windundsterne/esp-kwb-mqttlogger/Bilder/PXL_20201004_154122790.jpg

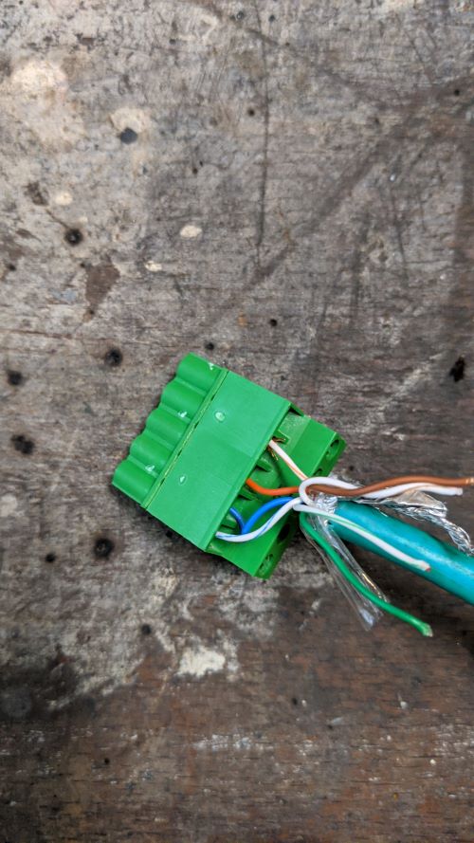
Bilder/PXL_20201004_154122790.jpg
