windundsterne/esp-kwb-mqttlogger/Bilder/PXL_20201004_155612305.jpg

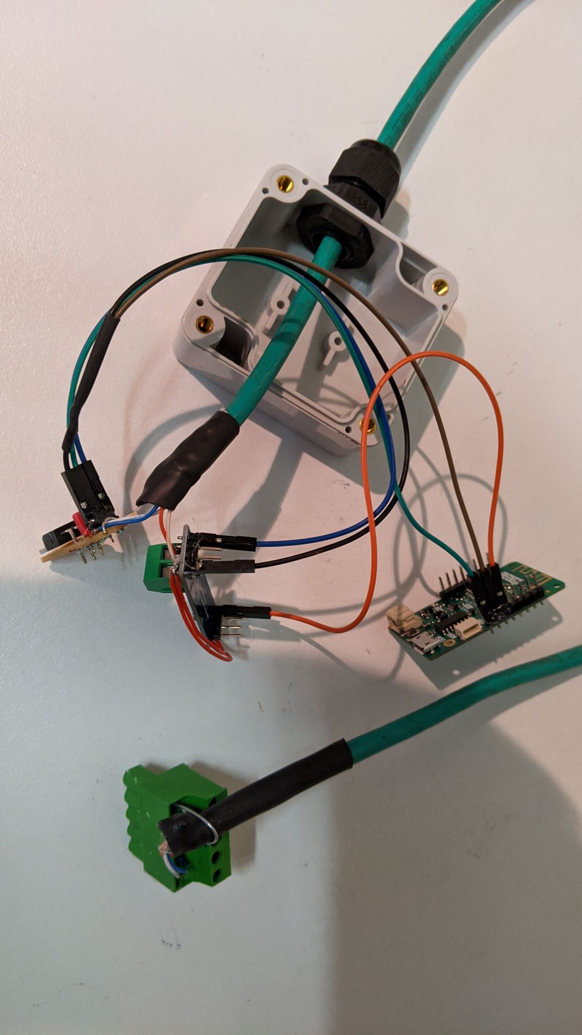
Bilder/PXL_20201004_155612305.jpg
