windundsterne/esp-kwb-mqttlogger/Bilder/PXL_20201004_155644567.jpg

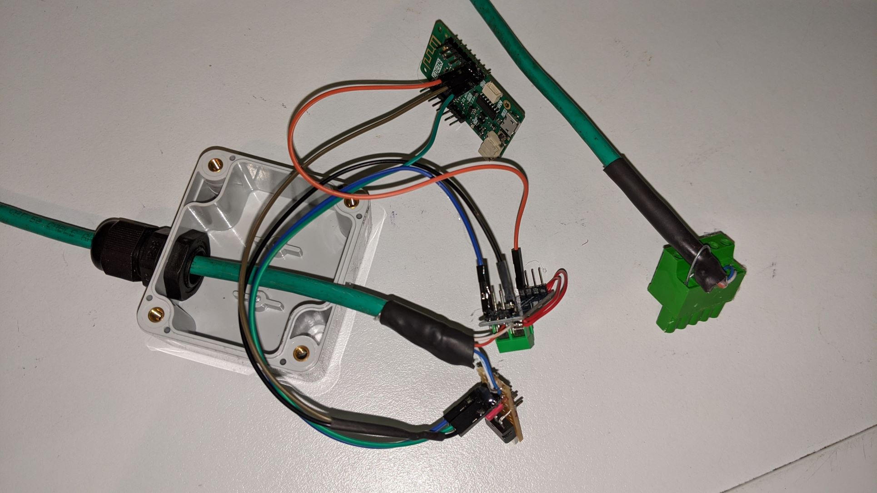
Bilder/PXL_20201004_155644567.jpg
