windundsterne/esp-kwb-mqttlogger/Bilder/PXL_20201004_155710227.jpg

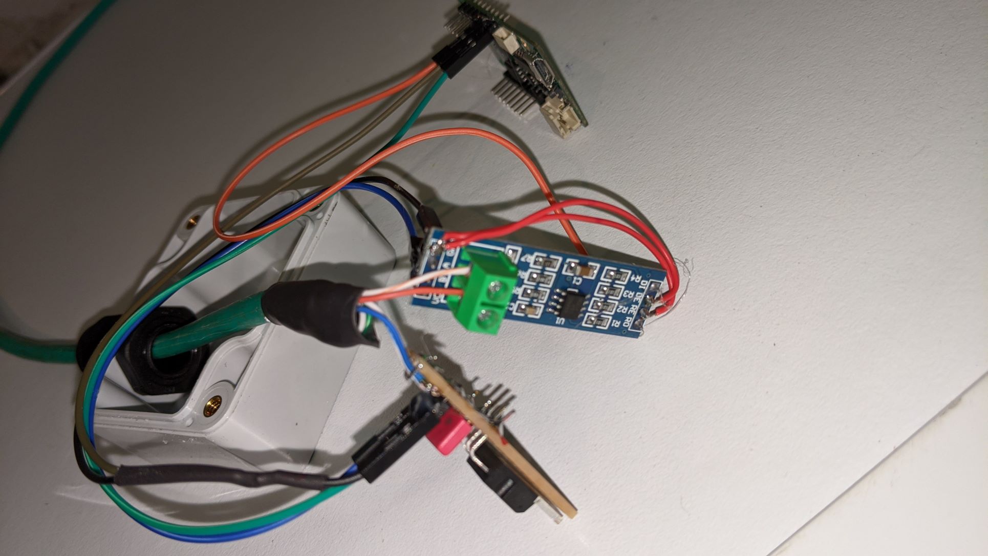
Bilder/PXL_20201004_155710227.jpg
