windundsterne/esp-kwb-mqttlogger/(threads)

Thread 1 (2022-01-20):

Need Help

kimi1983, 2022-01-20:
Hallo,

im Moment benutzt ich folgenden Script per Serial2Net Adapter.

```
import serial
from datetime import datetime
import os
import sys
import time
import paho.mqtt.client as mqtt

ser = serial.serial_for_url('socket://192.168.1.71:9946',baudrate=19200)

STATE_WAIT_FOR_HEADER = 1
STATE_READ_MSG = 2
MSG_TYPE_CTRL=1
MSG_TYPE_SENSE=2

LOG_DELTA_TIME = 60        #time interval for logging [s]
LOG_ON_CHANGE = True       #log also when Ctrl-Msg has changed
LOG_RAW_MSG = False        #enable also logging of raw messages
LOG_LAST_RAW_MSG = True    #log also last message before logging current message

DECODE_ALL = False          #True = decode all messages without signal map
DO_DISPLAY = True           #Switch for enabling screen output

aaSignalMaps = [ {} for i in range(255) ]

aaSignalMaps[16] = {
    #Name: Type='b'(bit), Offset, Bit
    #Name: Type='s'(signed)/'u'(unsigned), Offset, Length, Factor, Unit
    'T_Vorlauf_HK1': ('s',5, 2, 0.1,'C'),
    'T_Ruecklauf_Kessel': ('s',7, 2, 0.1,'C'),
    'T_Boiler': ('s',9, 2, 0.1,'C'),
    'T_Kessel':  ('s',11, 2, 0.1,'C'),
    'T_Aussen': ('s',17, 2, 0.1,'C'),
    'T_Rauchgas': ('s',19, 2, 0.1,'C'),
    'T_Steuerung' : ('s',21, 2, 0.1,'C'),
    'T_Stokerkanal' : ('s',29, 2, 0.1,'C')}

aaSignalMaps[17] = {
    #Name: Type='b'(bit), Offset, Bit
    #Name: Type='s'(signed)/'u'(unsigned), Offset, Length, Factor, Unit
    'Aschebehaelter': ('b',3, 6),
    'Pellet_Vorrat': ('b',4, 3),
    'Brandschutzklappe' : ('b',1,1),
    'Reinigung' : ('b',2,1),
    'Alarm2': ('b',1,2),
    'Alarm1': ('b',1,3),
    'Boiler_Pumpe': ('b',1,5),
    'HK1_Pumpe': ('b',1,7),
    'Ascheaustragung': ('b', 2,0),
    'Reinigung': ('b',2,1),
    'HK1_Mischer': ('b',2,6),
    'Hauptrelais': ('b',3,4),
    'Raumaustragung': ('b',3,6),
    'Kessel_AN': ('b',15,0)}

def CrcAdd(nCrc, nByte):
    nCrc = (((nCrc << 1) | nCrc >> 7) & 0xFF)
    nCrc += nByte
    if (nCrc > 255):
        nCrc -= 255
    return nCrc

class cMessage:
    def __init__(self, nType=0, nLength=0, nID=0, nCounter=0, anData=bytearray(0), nChecksum=0, sTime=0):
        self.sTime=sTime
        self.nType=nType
        self.nLen=nLength
        self.nID=nID
        self.nCounter=nCounter
        self.anData=anData
        self.nChecksum=nChecksum

    def CopyFrom(self, oMsg):
        self.sTime=oMsg.sTime
        self.nType=oMsg.nType
        self.nLen=oMsg.nLen
        self.nID=oMsg.nID
        self.nCounter=oMsg.nCounter
        self.anData=oMsg.anData
        self.nChecksum=oMsg.nChecksum
 
    def GetBit(self, nOffset, nBit):
        nValue = (self.anData[nOffset] >> nBit) & 1
        return nValue
        
    def GetSignal(self, nOffset, nLen=2, fFactor=0.1, bSigned=False):
        nValue = 0;
        for nI in range(0,nLen):
            nValue += self.anData[nOffset+nI] << ((nLen-nI-1) * 8)
        if bSigned & (nValue > (1 << (nLen*8-1))):
            nValue -= (1 << (nLen*8))
        fValue = nValue * fFactor
        return fValue
   
    def Decode(self, aSignalMap):
        aSignalValues = {}
        if (len(aSignalMap)>0):
            for strSignalName, aSig in aSignalMap.items():
                if aSig[0]=='b':
                    #Name: Type, Offset, Bit
                    aSignalValues[strSignalName]=self.GetBit(aSig[1], aSig[2])
                else:
                    #Name: Type, Offset, Length, Factor, Unit
                    aSignalValues[strSignalName]=self.GetSignal(aSig[1], aSig[2], aSig[3], aSig[0]=='s')
        else:
            for nOffset in range(0, self.nLen-6, 1):
                strSignalName = ("Offset_%02d (%03d, %03d)" % (nOffset, self.anData[nOffset] , self.anData[nOffset+1]))
                aSignalValues[strSignalName]=self.GetSignal(nOffset)    
        return  aSignalValues

    def IsCrcOk(self):                  #TODO: does not always work correctly yet ...
        nCrc = 0x02;
        nCrc = CrcAdd(nCrc, self.nLen)
        nCrc = CrcAdd(nCrc, self.nID)
        nCrc = CrcAdd(nCrc, self.nCounter)
        for i in range(len(self.anData)):
            nCrc = CrcAdd(nCrc, self.anData[i])
        return nCrc == self.nChecksum

    def IsEqual(self, oOtherMsg):
        return self.anData == oOtherMsg.anData
      
def PrintSignals(aSignalValues, aSignalMap=[]):
    strLine = ''
    mqttLineB = '{'
    mqttLineStr = '{'
    #print('')
    for strName, fValue in sorted(aSignalValues.items()):
        if len(mqttLineB)>1: mqttLineB += ","
        if len(mqttLineStr)>1: mqttLineStr += ","
        if len(aSignalMap)>0:
            if aSignalMap[strName][0] == 'b':   #Bit-Signals
                mqttLineB+= ('"' + strName + '":' + '' + "{:}".format(fValue)+'')
                strSignal = ("%20s: %1.0f  " % (strName, fValue));
            elif aSignalMap[strName][3]<0.1:   #Float-Signals
                strSignal = ("%20s: %8.3f %s " % (strName, fValue, aSignalMap[strName][4]));
            else:
                mqttLineStr+= ('"' + strName + '":' + '' + "{:.1f}".format(fValue)+'')
                strSignal = ("%20s: %6.1f %s " % (strName, fValue, aSignalMap[strName][4]));
        else:
            strSignal = ("%20s: %8.3f " % (strName, fValue));
        strLine += (strSignal + ' '*(40-len(strSignal)));
    mqttLineB += '}'
    mqttLineStr += '}'
    if len(mqttLineB)>2 : print(mqttLineB)
    if len(mqttLineB)>2 : mqttc.publish("kwb/mqttLineB", mqttLineB)
    if len(mqttLineStr)>2 : print(mqttLineStr)
    if len(mqttLineStr)>2 : mqttc.publish("kwb/mqttLineStr", mqttLineStr)
    if len(mqttLineStr)>2 : sys.exit()
    #time.sleep(10)

def HandleMsg(oMsg):
    #decode message signals
    aSignals = list()
    if (not DECODE_ALL):
        aSignalMap = aaSignalMaps[oMsg.nID]
    else:
        aSignalMap = list()
    aSignals = oMsg.Decode(aSignalMap)
    if ((oMsg.nCounter % 20 == 0) & DO_DISPLAY):
        global aoLastDispMsg
        if oMsg.nType==MSG_TYPE_CTRL:
           os.system('clear')          
        #PrintRawMsg(oMsg, aoLastDispMsg[oMsg.nID])
        PrintSignals(aSignals, aSignalMap)
    
def ReceiveMsg(oMsg):
    nState = STATE_WAIT_FOR_HEADER
    bRxFinished = False
    while bRxFinished==False:
        nX = ord(ser.read())                    # read one byte
        if nState == STATE_WAIT_FOR_HEADER and nX == 2:
            nState = STATE_READ_MSG             # header found
            oMsg.sTime = datetime.now()
            oMsg.nType = MSG_TYPE_CTRL          # -> CtrlMessage
        elif nState == STATE_READ_MSG:
            if nX==0:                           # header invalid -> start again
                nState = STATE_WAIT_FOR_HEADER
            elif nX==2:                         # extended header -> SenseMessage
                nState = STATE_READ_MSG
                oMsg.nType = MSG_TYPE_SENSE
            else:
                oMsg.nLen = nX                  # current byte: Message Length
                oMsg.nID = ord(ser.read())		# next byte: Message ID
                oMsg.nCounter = ord(ser.read())	# next byte: Message Counter
                nDataLen = oMsg.nLen - 4 - 1
                oMsg.anData = bytearray(nDataLen) # Data Length = Message Length without the header and checksum
                for i in range(nDataLen):
                    nX = ord(ser.read())        # read Data bytes
                    oMsg.anData[i]=nX
                    if nX == 2:                 # "2" in data stream is followed by "0" ...
                        ser.read()              # this should be a 0 ...
                oMsg.nChecksum = ord(ser.read())       
                bRxFinished = True             
    return oMsg.IsCrcOk()                       # CRC check

# *** Main ***
bLogCycle = False
l = 1
aoLastDispMsg = [cMessage(count) for count in range(0,255)]
aoLastMsg = [cMessage(count) for count in range(0,255)]
oMsg = cMessage()

sTimeLastLog = datetime.today()

DO_LOGGING = 'NO_LOGGING' not in sys.argv
DO_DISPLAY = 'NO_DISPLAY' not in sys.argv

mqttc = mqtt.Client("pyhton_kwb")
mqttc.connect("192.168.1.70", 1883)

while l==1:
    ReceiveMsg(oMsg)
    HandleMsg(oMsg)
    #aoLastMsg[oMsg.nID].CopyFrom(oMsg) # save last message

ser.close()
#mqttc.Close()
```

Leider wird mir mit der Wemos Variante keine Daten per MQTT weitergegeben, also gehe ich davon aus das auch keine Daten gelesen werden konnten.

Bei mir handelt es sich um eine Easyfire Anlage mit Heizkreis 1.

Wie kann ich nun deinen Script anpassen um an meine Werte zu kommen ?

Mit besten Grüssen,
und Danke für deine Arbeit.

kimi1983, 2022-01-23:
Hier ist was mein Wemos Adapter mir per MQTT ausgibt :

bytes read RS485: 10 2 21 17 120 88 140 128 16 129

Gelbwichtel, 2022-01-24:
Hi, also für mich sieht das so aus, als wenn du dich an die Doku von Dirk Abel gehalten hast. Philip hat aber scheinbar einige bzw. ganz andere  Werte aus seinem Protokoll ermittelt und umgesetzt. Auch meine Werte decken sich eher mit denen von Philip als mit denen von Dirk. Vielleicht ist das ja auch dein Problem.
@Philip: hast du vielleicht eine Aufstellung zu deinen gefundenen Control-/ und SenseBytes gemacht, die du hier noch einfügen kannst.

kimi1983, 2022-01-24:
Ok verstehe.
Aber wo kann ich dieser Werte, welche ja bei mir Daten geben bei dir einsetzen :

aaSignalMaps = [ {} for i in range(255) ]

aaSignalMaps[16] = {
    #Name: Type='b'(bit), Offset, Bit
    #Name: Type='s'(signed)/'u'(unsigned), Offset, Length, Factor, Unit
    'T_Vorlauf_HK1': ('s',5, 2, 0.1,'C'),
    'T_Ruecklauf_Kessel': ('s',7, 2, 0.1,'C'),
    'T_Boiler': ('s',9, 2, 0.1,'C'),
    'T_Kessel':  ('s',11, 2, 0.1,'C'),
    'T_Aussen': ('s',17, 2, 0.1,'C'),
    'T_Rauchgas': ('s',19, 2, 0.1,'C'),
    'T_Steuerung' : ('s',21, 2, 0.1,'C'),
    'T_Stokerkanal' : ('s',29, 2, 0.1,'C')}

aaSignalMaps[17] = {
    #Name: Type='b'(bit), Offset, Bit
    #Name: Type='s'(signed)/'u'(unsigned), Offset, Length, Factor, Unit
    'Aschebehaelter': ('b',3, 6),
    'Pellet_Vorrat': ('b',4, 3),
    'Brandschutzklappe' : ('b',1,1),
    'Reinigung' : ('b',2,1),
    'Alarm2': ('b',1,2),
    'Alarm1': ('b',1,3),
    'Boiler_Pumpe': ('b',1,5),
    'HK1_Pumpe': ('b',1,7),
    'Ascheaustragung': ('b', 2,0),
    'Reinigung': ('b',2,1),
    'HK1_Mischer': ('b',2,6),
    'Hauptrelais': ('b',3,4),
    'Raumaustragung': ('b',3,6),
    'Kessel_AN': ('b',15,0)}

Gelbwichtel, 2022-01-25:
Ich denke es bleibt dir nichts anders übrig, als dass du Philips Code genauer unter die Lupe nimmst. Das wesentliche ist in der Loop zu finden
    ...
      Kessel.Leistung = lfaktor *  getval2(anData, 12, 2, 0.05, 0);
      Kessel.Pumpepuffer = getbit(anData, 2, 7);
      Kessel.Zuendung = getbit(anData, 16, 2);
      Kessel.KeineStoerung = getbit(anData, 3, 0);
      Kessel.Reinigung = getbit(anData, 3, 7);
      Kessel.Drehrost = getbit(anData, 3, 6);
      Kessel.Raumaustragung = getbit(anData, 9, 2);
      Kessel.RLAVentil = getbit(anData, 2, 3);
...
Wäre dann z.B. bei dir wahrscheinlich
      Kessel.Reinigung = getbit(anData, 2, 1);
usw.

kimi1983, 2022-01-26:
Ja stimmt da könntest du Recht haben.

Ich werde das morgen mal ausprobieren.

Danke schonmal vorab,
Kim

windundsterne, 2022-02-08:
Einige der Werte aus der Dokumentaion hatten für meinen Kessel gepasst, viele aber leider nicht. Daher hab ich einige ergänzt, andere auch geändert.

LG Philip

windundsterne, 2022-02-08:
> Hier ist was mein Wemos Adapter mir per MQTT ausgibt :
>
> bytes read RS485: 10 2 21 17 120 88 140 128 16 129

An den Werten siehts Du das das auslesen des rs485 zu funktionieren
scheint.
weitere Daten kommen erst nach dem Updateintervall von 5 min. z.B.
2022-02-05_12:31:00 MQTT2_kwb info: Booting (UART0 Serial)
2022-02-05_12:31:00 MQTT2_kwb UDfaktor: 1.4900
2022-02-05_12:31:00 MQTT2_kwb kwh: 0.000
2022-02-05_12:31:00 MQTT2_kwb rec: bytes read RS485: 10 32 1 0 1 0 1 0 1
0
2022-02-05_12:31:00 MQTT2_kwb updatemin: 5
2022-02-05_12:36:00 MQTT2_kwb errors: 5442 / 51
2022-02-05_12:36:00 MQTT2_kwb Pellets: 0
2022-02-05_12:36:00 MQTT2_kwb PelletsNA: 0
2022-02-05_12:36:00 MQTT2_kwb Stoerung: 0
2022-02-05_12:36:00 MQTT2_kwb deltaPelletsh: 0
2022-02-05_12:36:00 MQTT2_kwb Kesseltemperatur: 54.3
2022-02-05_12:36:00 MQTT2_kwb Rauchgastemperatur: 78.2
2022-02-05_12:36:00 MQTT2_kwb Saugzug: 1342 / 2510
2022-02-05_12:36:00 MQTT2_kwb Unterdruck: 15.5
2022-02-05_12:36:00 MQTT2_kwb Kessel: brennt
2022-02-05_12:36:00 MQTT2_kwb Anforderung: 1
2022-02-05_12:36:00 MQTT2_kwb photodiode: 25
2022-02-05_12:37:37 MQTT2_kwb Reinigung: 1
2022-02-05_12:40:38 MQTT2_kwb Reinigung: 0
2022-02-05_12:41:00 MQTT2_kwb errors: 5484 / 23
2022-02-05_12:41:00 MQTT2_kwb Pellets: 0
2022-02-05_12:41:00 MQTT2_kwb PelletsNA: 0
2022-02-05_12:41:00 MQTT2_kwb Pumpepuffer: 1
2022-02-05_12:41:00 MQTT2_kwb Kesseltemperatur: 55.6
2022-02-05_12:41:00 MQTT2_kwb Rauchgastemperatur: 68.0
2022-02-05_12:41:00 MQTT2_kwb Saugzug: 2005 / 864
2022-02-05_12:41:00 MQTT2_kwb Unterdruck: 103.8
2022-02-05_12:41:00 MQTT2_kwb Kessel: brennt
2022-02-05_12:41:00 MQTT2_kwb Anforderung: 1
2022-02-05_12:41:00 MQTT2_kwb photodiode: 24
2022-02-05_12:44:41 MQTT2_kwb Schneckenlaufzeit: 29

Gruß
Philip

rmeissn, 2023-01-08:
Ich schätze der EasyFire (1) befüllt die Nachrichten etwas anders als der EasyFire 2, weswegen Werte an anderen Stellen stehen. Die aktuellen Werte im Repo kommen für meinen EasyFire 2 hin.
Dass sich die Befüllung der Nachrichten zwischen den Geräteversionen ändert, wäre aus Informatik-Perspektive nachvollziehbar.

Thread 2 (2022-02-08):

Codes für Fehlermeldungen

windundsterne, 2022-02-08:
Die Codes für Fehlermeldungen sind sicher innerhalb der SENSE-Pakte, enthalten. Wäre cool wenn jemand wüßte an welche Stelle diese stehen. Damit könnte man bei einer Störung nicht nur sehen dass die anliegt sondern auch, um welche es sich handelt.

Weiß da jemand was ?

windundsterne, 2022-02-17:
Hmm kann mir nicht vorstellen, dass die das Protokoll in den Versionen ändern, hab auch nen EF2. Stimmen die CRCs?

Thread 3 (2022-02-17):

zusätzliche Infos

Gelbwichtel, 2022-02-17:
Hi, weiß zwar nicht ob das hier der richtige Platz dafür ist, aber ich fang einfach mal an.

1. client-Publish Anzeige in Fhem
Beim Arbeiten mit dem client.publish ist mir Folgendes aufgefallen:
Werden viele clientPublish-Befehle hintereinander abgesetzt, dann stimmt irgendwann in FHEM die Reihenfolge in der Anzeige nicht mehr. Um das herauszufinden hatte ich im Sketch jedes publish um einen Counter versehen und dieses dann mit ausgegeben. Wird dabei irgendein "Schwellwert" überschritten, scheint FHEM ev. einen weiteren Thread anzulegen, die dann asynchron in die gleiche Ausgabe arbeiten. z.B.
anstatt ... 1200456, 1200457, 1200458, 1200459 ... kam dann ...1200456, 1200458, 1200459, 1200457 ... raus.
Hatte mich einiges an Nerven gekostet. Lösung dafür nicht gefunden, ausser die Datenmenge zu reduzieren.

2. EasyFire2 weitere Control / SenseDaten
    Aussentemperatur : (Sense) getval2(anData, 18, 2, 0.1, 1)
    Saugturbine: (Control)         getbit(anData, 9, 5)
    Drehung Saugschlauch links (Control): getbit(anData, 4, 3)
    Drehung Saugschlauch rechts (Control): getbit(anData, 4, 1)
    Position Saugschlauch 0,1,2,3 noch nicht entdeckt, aber eher nicht in den Control Daten

windundsterne, 2022-02-19:
Cool, habs mal ins Wiki geschrieben, vielleicht hat ja jemand anderes noch was...

Closed 2022-02-23.

Thread 4 (2022-02-23):

DivisionByZero error

Gelbwichtel, 2022-02-23:
Hi, wenn du gelegentliche Abstürze hast könnte das daher kommen:

  if (Kessel.Hauptantriebtakt != 0 )
  {
     Kessel.Hauptantriebzeit += (oKessel.Hauptantrieb * (milli - timerHA)) / (oKessel.Hauptantriebtakt);
  }

sollte sein:   if (oKessel.Hauptantriebtakt != 0 )

windundsterne, 2022-03-04:
Danke ist korrigiert

Closed 2022-03-04.

Thread 5 (2022-02-25):

potentieller Absturz durch Speicherleck

Gelbwichtel, 2022-02-25:
Die inttobin() Funktion allokiert Speicher, führt in Kombination mit einem sprintf(), wie du es zum Loggen benutzt hast, zu einem Speicherleck führt. Je öfter dieser Code dann durchlaufen wird, desto weniger Ram steht zur Verfügung und dann stürzt der Wemos mit Fehlern ab.

Ich verwende das jetzt z.B. in der Art:

char *o = inttobin(oa); sprintf(oCtrlBits,"%s",o); delete o;

windundsterne, 2022-03-04:
uiii, das stimmt! Ist bei mir nicht aufgefallen, da ich die Binärausgaben, meinst nur zu Debuggingzwecken und nicht dauerhaft in Betrieb hab. Danke für den Hinweis. Werds in den Beispielcode übernehmen.

Closed 2022-03-04.

Thread 6 (2022-03-16):

Formel für Photodiode

lebetz, 2022-03-16:
Bei mir passt die Formel für die Photodiode irgendwie nicht ganz.
Der kleinste Wert, der bei mir für Kessel.photo vorkommt, ist -221. Das ergibt mit der aktuellen Formel ((Kessel.photo + 255.0)*100)>>9) allerdings 6 und nicht die erwarteten 0. Und im normalen Betrieb komm ich mit der Formel auf Werte von max. 70, obwohl an der Steuerung immer 100% angezeigt wird. Ist das bei euch auch so?
@windundsterne , wie kamst du auf die interessante Formel mit dem Bitshift? Ich hab auch mal den Thread im Forum durchsucht und die in keinem anderen Dokument oder Code gefunden.
Ich hänge mal einen Datenmitschrieb von einem kompletten Heizzyklus mit an den Punk:
[history.csv](https://github.com/windundsterne/esp-kwb-mqttlogger/files/8266872/history.csv)

Hier noch der Graph mit den direkten Kessel.photo Werten (ohne Formel):
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

windundsterne, 2022-03-21:
Ich meine die hätte ich in dem  Forum gefunden (https://www.mikrocontroller.net/topic/274137), bin mir aber nicht sicht.
Ich vermute aber die Photodiode müßte man kalibrieren, um Werte zwischen 0 und 100 zu erhalten.  Bei meinem EF2 liegen die Werte zwischen 6 und 98.  Das reicht im Grund auch um zu sehen ob Feuer ist - oder nicht.

rmeissn, 2023-01-07:
Ich habe das Gerät bei mir gerade erst an der KWB dran, weswegen ich noch nicht genug Messwerte habe, um den Wertebereich richtig einschätzen zu können.
Eine Formel für einen bekannten Wertebereich wäre:
```
// Wertebereich x -221 bis 127 ... 221+127 = 348 Zahlen in diesem Bereich
// (x + min * -1) / Bereich -> 0 bis 1 * 100 -> 0 bis 100
#include <math.h>
int photodiode = round((x + 221) / 348.0 * 100)
photodiode = (photodiode < 0) ? 0 : (photodiode > 100) ? 100 : photodiode; //mögliche Ausreißer abfangen
```
Man könnte auch reine Integer Rechnungen nutzen, was schneller geht - kommt auf die konkrete MCU an, ob Integer-Rechnungen nötig sind.

windundsterne, 2023-01-10:
prima,   damit skaliert die Diode brav zwischen 0 und 100.
hab das in den esp32-Code übernommen und werd den demnächst uploaden.
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
Danke

Thread 7 (2022-07-06):

Hardware-Hilfe

marfel, 2022-07-06:
Hallo Philip,

vielen Dank für dieses tolle Repo - wir haben hier eine Pelletfire Plus, die ich gerne auslesen und in meine Influx-Datenbank einpflegen will. Mit den Codeänderungen komme ich schon klar (glaube ich ;) aber bei der Hardware bin ich unsicher (da kein Elektroniker). Daher meine Fragen:

1. Wo finde ich typischerweise so einen RS485-Stecker in der Anlage? Im Steuerungsmodul?
2. Ich dachte bei RS485 muss alles an einem Strang hängen und am Ende ein Abschlusswiderstand - wie kann man da irgendwo noch ein Gerät in den Bus hängen, ohne die Kabel aufzuschneiden? Oder muss ich mir das mit dem Stecker so vorstellen, dass die Elektronik den Stecker überbrückt, wenn kein Gerät angeschlossen ist?
3. Mit MAX485 meinst du so ein integriertes Modul, z.B. https://www.makershop.de/module/kommunikation-module/ttl-rs-485/ nicht den reinen Chip, oder?

Danke und Grß,
Martin

rmeissn, 2023-01-07:
Hey Martin,

ich habe einen EasyFire 2, weswegen sich das Ganze bei dir unterscheiden könnte. Zu
1. Am Hauptbedienteil am Kessel oder am Fernbedienteil - an letzterem hängt mein ESP einfach parallel zum Bedienteil
2. Am Bedienteil ist eine Klemme mit 5 Anschlüssen (A, B, GND, VCC, Shield). Da habe ich einfach A und B abgegriffen. Ground und VCC kommen von ESP und sind nicht mit dem Bus verbunden - ich bin mir nicht sicher ob das richtig ist, scheint aber zu funktionieren. Ein separater Abschlusswiderstand war bei mir nicht gesteckt. Ggf. ist aber einer im Bedienteil integriert. Da bin ich mir auch nicht ganz sicher.
3. Genau so ein Modul habe ich bei mir im Einsatz

marfel, 2023-01-09:
Vielen Dank Philip! Hatte nicht mehr wirklich mit einer Antwort gerechnet ;)
Ich vermute mal, das Fernbedienteil wird bei den Anlagen einigermaßen identisch sein. Mal sehen ob's klappt.

Closed 2023-01-09.

Thread 8 (2023-01-08):

Aktuelle Übersicht des Nachrichteninhalts für EasyFire 2

rmeissn, 2023-01-08:
Hallo,
vielen Dank für das Programm und Reverse-Engineering des Protokolls.
Ich vollziehe gerade den Code und das Protokoll nach. Gibt es eine aktuelle und vollständige Übersicht zu den Positionen von Sensoren und Zuständen in den Nachrichten? Ggf. auch nur Ideen oder Code-Schnipsel, die bisher nicht auf Github liegen?
Das Dokument von Herrn Abel kommt für den EF2 leider nicht wirklich hin.

Bspw. hat @Duetting in seinem Fork noch einige weitere Temperaturwerte und Zustände identifiziert (siehe [Duettings branch](https://github.com/Duetting/esp-kwb-mqttlogger/blob/67c3276de7924f9e614baf5b49d64fd10d541a6d/esp-kwb-mqttlogger.ino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) ).
Ggf. wissen auch @windundsterne oder @Gelbwichtel noch von weiteren Positionen/Werten bzw. haben lokal noch unveröffentlichten Code bzw. Mitschriften liegen.

Ich entwickle gerade meinen eigenen [Fork des Codes](https://github.com/rmeissn/esp-kwb-mqtt-ha-logger-) (zur Einbindung in HomeAssisstant + Refactoring) und bin daher an allen verfügbaren Informationen interessiert.

Duetting, 2023-01-08:
Also identifiziert habe ich keine weiteren Werte (zumindest bisher), ich habe nur bereits bekannte Werte aus dem PDF zur Übertragung hinzugefügt. Meine Pellets Anlage ist auch momentan nicht im Betrieb, da mir die Pellets dieses Jahr einfach zu teuer waren. Mal sehen wie es nächstes Jahr aussieht. Bis dahin begnüge ich mich mit den bisherigen Werten.
Benutze im übrigen auch Home Assistant und werde bei Interesse meine manuelle MQTT Sensor Definition hinzufügen.
Eine eigene Integration zu bauen, dafür habe ich momentan nicht die Zeit. Und die MQTT Discovery Nachricht zu bauen ist auch nicht ohne.

rmeissn, 2023-01-09:
@Duetting Ich muss zugeben in meinem Fork viel am Code umgebaut zu haben, aber durch Nutzung von [ArduinoHA](https://github.com/dawidchyrzynski/arduino-home-assistant) sind bei mir sämtliche Discovery-Nachrichten und Sensor-Definitionen für HomeAssistant (HA) drin. In HA taucht das Gerät unter der MQTT Integration automatisch auf (Auto Discovery) und publiziert aktuell 21 Werte (incl. korrekten Wertebereichen, Icons, etc.). Online/Offline-Überwachung des HA Device ist auch darüber drin.

rmeissn, 2023-01-15:
Ich habe noch folgendes in der Control Message gefunden:
```
Kessel.HeizkreisPumpe = getbit(anData, 1, 5);
if (getbit(anData, 1, 7) && getbit(anData, 2, 0))            // 1 & 1 = close
  Kessel.Heizkreismischer = -1;
else if (getbit(anData, 1, 7) && getbit(anData, 2, 0) == 0)  // 1 & 0 = open
  Kessel.Heizkreismischer = 1;
else                                                        // 0 & 0 = off
  Kessel.Heizkreismischer = 0;
if (getbit(anData, 2, 3) && getbit(anData, 2, 4))            // 1 & 1 = open
  Kessel.RLAVentil = 1;
else if (getbit(anData, 2, 3) && getbit(anData, 2, 4) == 0)  // 1 & 0 = close
  Kessel.RLAVentil = -1;
else                                                        // 0 & 0 = off
  Kessel.RLAVentil = 0;
Kessel.BoilerPumpe = getbit(anData, 2, 5);
Kessel.Stoerung1 = 1 - getbit(anData, 3, 0);
Kessel.Rauchsauger = getbit(anData, 4, 5);
Kessel.KesselPumpe = (getval2(anData, 8, 1, 1, 0) / 255) * 100;
Kessel.Raumaustragung = getbit(anData, 9, 2) || getbit(anData, 9, 5);  // Schnecke || Saugturbine
```

Je nachdem wie bei euch Geräte angeklemmt sind, könnten Heizkreispumpe, Heizkreismischer, RLAVentil & Boilerpumpe an anderen Positionen liegen.

Duetting, 2023-01-16:
ArduinoHA kannte ich noch nicht. Vielen Dank für den Tipp. Ist mein erstes Arduino/ESP Projekt bisher, da war ich froh das es recht schnell und stabil funktioniert hat.
Werde mir definitiv deinen Code ansehen und vermutlich darauf umschwenken.
Muss demnächst meine Anlage wieder einschalten, dann kann ich ggf. auch bei der Analyse mit helfen. Was mich momentan noch am meisten interessieren würde, wäre die Heizkreis Solltemperatur.

Thread 9 (2023-01-08):

Formeln im Code

rmeissn, 2023-01-08:
Im Code stehen einige Kommentare und Formeln, bei denen es mir schwerfällt, den Inhalt nachzuvollziehen - https://github.com/windundsterne/esp-kwb-mqttlogger/blob/f766bdab3c21a0bf46224941f1f9c46f7199fcfd/esp-kwb-mqttlogger.ino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

Konkret sind das Zeilen 115 - 130.

Hier mein aktueller Versuch dazu (inkl. Versuch, die Abkürzungen aufzulösen):

```
gemessen 308g / 229 Umdrehungen = 1.35 g/Umdrehung // Zahl passt
Empirische aus 26KW Leistung 1.3338 // ?
24,7KW / 4.8 mit 2338 Umdrehungen -> 2.200 // Wie kommt man auf 2.200?
22KW * 0.8 * 9,4h * 4kg/h / 1642 Umdrehungen = // Wo kommen 0,8 und 4kg/h her? warum fehlt das Ergebnis?

gemessen am Hauptantrieb
310g / 207 Umdrehungen = 1,498 g/Umdrehung -> 3,58 g/s // Wie kommt man auf 3,58? Zeitangabe fehlt
200g / 135 Umdrehungen = 1.48 g/Umdrehung -> auf 56s -> 2,78 g/s // Endergebnis ist falsch?
298g /  207 Umdrehungen = 1.44 g/Umdrehung -> auf 86s > 3,46 g/s // Zahlen passen

macht ca. 207 Umdrehungen / 86s = 2.4 Umdrehungen/s bei Normbetrieb -> 187 Umdrehungen in 3 Min // Endergebnis falsch?
nied Fallrohrstand 200gr/ 160 Umdrehungen = 1.25 g/Umdrehung // Was ist ein "nied Fallrohrstand"?
Nebenantrieb/Schnecke: 1990g / 373 s = 5.34 g/s // Zahlen passen, aber was sagt mir das?
```

* Gilt der erste Block für den Nebenantrieb?
* Was sagt mir der erste Block?
* Was sagt mir der letzte Block?

windundsterne, 2023-01-10:
Hi Roy,

sorry für den Wirrwarr in den Kommentaren. Dieser entstand durch mehrere Messungen, bei denen ich die Menge an Pellets gemessen habe, die der Hauptantrieb (Stoker im Kessel) und der Nebenantrieb (Schnecke) in einer bestimmten Zeit transportieren. Eigentlich sollten beide Antriebe die gleiche Menge an Material (im Durchschnitt) transportieren. Die Menge/Zeit des Nebenantriebs scheint jedoch etwas von der Füllmenge des Bunkers abzuhängen. Daher habe ich die Messung auf den Hauptantrieb umgestellt. Dieser ist jedoch schwieriger zu messen. Daher habe ich die Hardware auf einem esp32 geändert, der zwei Cores hat und nun werkelt. Den Code hab ich dazu in dem letzen hallben Jahr erweitert, so dass beide Mengen (HA und NA) gemessen werden. Leider bin ich noch nicht dazu gekommen den neuen Code in Github zu schubsen. Werd versuchen das in den nächsten Wochen zu tun.

Gruß
Philip

rmeissn, 2023-01-31:
Ah, supi.
Kurze Verständnisfrage:
Der Hauptantrieb/Stoker ist der, der die Pellets per Schnecke auf den Brennteller schiebt, richtig? Der geht nur an/aus und das Fördervolumen wird über die Länge der Einschaltzeit bestimmt, richtig?
Ich habe nämlich keinen Bunker mit Schnecke (stattdessen Saugantrieb).
Wenn ich das Fördervolumen des Hauptantriebs und dessen Laufzeit messe, müsste ich doch wunderbar die bewegte Pelletmenge berechnen können, richtig?

windundsterne, 2023-02-01:
Ja - grundsätzlich korrekt. Der Stocker ist ein Schneckenantrieb im Kessel. Dessen Laufzeit ist schwierig zu bestimmen. Da hatte ich ne weile getüftelt. Nun scheint das zu passen. Hab aber inzwischen eine Variante mit einem esp32 statt des wemos gebaut, da die 2 Kerne die mehr Ressourcen bieten, um nicht ein Paket zu "verpassen"

Thread 10 (2024-04-20):

Startschwierigkeiten

Jch24, 2024-04-20:
Hallo Philip,

ich bin heute morgen über den Thread auf Mikrocontroller.net gestoßen und habe das Projekt gleich nachgebaut.
Ich habe eine EasyFire2 Baujahr 2023. Meine Bedieneinheit sicht anders aus als im Forum. Meine hört auf den Namen [KWB BGE C4](https://www.kwb.net/de-de/produkte/regelung-und-bedienung/kwb-comfort-4/)
Diese hat wohl zwei Busverbindungen. Beides scheint ein RS485 zu sein, aber kein RS422, da die Baudrates verschieden sind. (zumindest auf dem ersten Blick mit dem billig-Oszi weches das Signal nicht gescheit triggern kann)
Ich vermute, dass gelb-grün der korrekte Anschluss ist, da hier kein Error per MQTT kommt.
Bei grau-rosa kommt nämlich "error: unknown Packet 32/33"

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

Was mir auch komisch vorkommt ist der Aufkleber auf der Steuerung selbst. Hier ist die Rede vom Hausbus und RS232. Beides sind externe Anschlüsse. Was hat es damit auf sich? Und der Kesselbus ist der interne Anschluss. Diesen werden wir verwenden müssen oder?
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

Daten die ich im MQTT Explorer sehen konnte sind z.B.:
bytes read RS485: 10 255 0 0 251 0 249 248 255 0
bytes read RS485: 10 255 251 0 248 0 0 255 252 0

Diese Daten kommen, sobald ich den Reset vom ESP32 loslasse. Da ich noch keine Drähte an den Stecker der Bedieneinheit rangelötet habe, habe ich die Daten nur sehr kurz ausgelesen (drähte händisch hingehalten)

Ich hätte aber decodierte Infos erwartet, so wie in einem Bild von Dir "fhemwerte.png"

Von FHEM habe ich leider keine Ahnung. Ich nutze Node-Red, InfluxDB und Grafana für meine Heimautomatisierung und bekomme von allen anderen Sensoren "menschenleserliche MQTT-Nachrichten"

Muss ich die Werte selbst decodieren oder mache ich was gravierend falsch?

Grüße
Jch

Jch24, 2024-04-20:
ich habe beim Thread von Mikrocontroller.net weitergelesen. Meine Comfort-4-Bedieneinheit kann kostenlosen Modbus TCP.
Mit einem Windows-Tool kann ich schon die Register auslesen, aber leider passen die teilweise nicht zu der Exceltabelle welche auf der SD Karte von der Bedieneinheit ist.
So hat das auch jemand bei Mikrocontroller.net geschrieben.
Ich probiere mich mal an dem Modbus aus ob ich das zum laufen bekomme. Das wäre die Lösung die weniger Garantiegefährdend ist.
