windundsterne/esp-kwb-mqttlogger/src/esp-kwb-mqttlogger.ino

// Author windundsternne V.0.99
// Das Programm liest Control und Sense Daten vom Bus
// fhem. Updates können OTA durchgeführt werden.
// Ist bestimmt nicht fehlerfrei läuft aber seit einer Weile stabil
// Hardware
// Webmos d1 mini Pro + HER MAX485 module
// Stromversorgung über Kessel 24V 7800 Spannungsregler
// Neben den Kesselwerten werden nich Brennerlaufzeit Gesamtenergie
// berechnet mit der der Pelletverbrauch bestimmt werden kann (ca. 4.3kg/kwh bei einem EF2)


// Serial:
// Serielle Schnittstelle
// Die Pins TX und RX wie beim Arduino UNO. stattdessen die Pins D7 und D8 (= GPIO 13 / RXD2 bzw. GPIO 15 / TXD2)
// benutzen. Dazu  im Setup die Anweisung Serial.swap() nach Serial.begin() einfügen.



// Individualisierungen

//#define STASSID "MYSSID"          // Wlan SSID
//#define STAPSK  "MYWLANPW"        // Wlan PW
//#define MQTTSERVER "192.168.0.5"  // IP MQTT-Server

//  individuelle Konfig ausserhalb des GIT
#ifndef STASSID
#include "conf.h"
#endif

// Define GPIOPIN 2 wenn SW Serial genutzt werden soll
// Else undef -> Default UART0 via GPIO13 als RX nutzen

//#define SWSERIAL 2

#define RX        2    // GPIO2   //Serial Receive pin
// Aktuell ist der nicht angeschlossen, da  nicht
// gesteuert werden soll
#define TX        4    // GPIO4   //Serial Transmit pin
#define RTS_pin   5 // GPIO5  //RS485 Direction control
#define RS485Transmit    HIGH
#define RS485Receive     LOW



#define OTAHOST "kwbeasyfire"     // unnter dem Namen  Netzwerkschnittstelle in der ArduionIDE
#define OUTTOPIC "kwb"
#define INTOPIC "cmd"
#define MQNAME "kwb"

#define LEISTUNGKESSEL 25.0 // KW bei 100 %
#define TAKT100  (12.5 / 5.0)            // Taktung bei 100% Leistung 5s Laufzeit auf 12.5 sek 

// Ende Individualisierungen


//#include <ESP8266WiFi.h>
//#include <ESP8266mDNS.h>
//#include <WiFiUdp.h>
#include <ArduinoOTA.h>
#include <PubSubClient.h>
#include <stdio.h>
#include <time.h>

#define STATE_WAIT_FOR_HEADER 1
#define STATE_READ_MSG  2
#define MSG_TYPE_CTRL 1
#define MSG_TYPE_SENSE 2
#define FALSE 0
#define TRUE 1



const char* mqtt_server = MQTTSERVER; // IP des MQTT Servers - z.B. fhem
const char* ssid = STASSID;
const char* password = STAPSK;

// Globals

long UD = 0;
long SL = 0 ; // Schneckenlaufzeit
long ZD = 0;
int updatemin = 5 ;
long UDtimer = 0;
long unsigned HANAtimer = 0; // Timer zur Ausgabe der HANA Ratio
long NAz = 0, HAz = 0;

int wifistatus = 0;

extern long bytecounter;
extern long framecounter;
extern long errorcounter;
long last_errorcount = 0;

// Stat impulse
unsigned long id[200];
int ic = 0;
unsigned long ifc[200];
unsigned long idl[200];

// Recording
#define DDC 200

unsigned long    dd_t[DDC];
int     dd_frameid[DDC];
int     dd_nID[DDC];
int     ddc = 0;

// Framedata
#define DCCBYTES 7
#define DCCOFF 5
unsigned char dd_data[DDC][DCCBYTES + 1];

int HAimp = 0;

//  gemessen 308gr auf 229 UD = 1.3449
//  Empirische aus 26KW Leistung 1.3338
//  24,7KW/4.8 mit 2338 UD -> 2.200
//  22KW * 0.8 * 9,4h  *  4kg /h  / 1642 UD =


// gemessen am HA
// 310gr 207UD = 1,495 g/UD > 3,58 g/s
// 200gr auf 135 UDs = 1.48 = 56s > 2,78
// 298gr auf 207 UDs = 1.44 = 86s > 3,46g/s


// mach ca. 2.4 UD /s  bei Norm Betrieb 187 UD in 3 Min
// nied Fallrohrstand 160UD auf 200gr = 1.25
// Nebenantrieb/Schnecke: 1990gr mit 373 s = 5.33gr/s

// 21.11.22 Messung Nebenantrien-Schnecke
// 6056gr 940s -> 6,44255319 gr/s (gemessen 931s) 
// Winter 21/22 -> 6,966 gr/s
// 3,125  HAFaktor bis zum 21.  (*1.117 auf verk HA/NA) 
// 3,4909 HAfaktor
// 


double NAfaktor = (6056.0 / 940.0);
double HAfaktor = (1.117 * 400.0 / 128.0) ; // // 400g in 120sek. > 3.333 g/s

unsigned long count = 0;
unsigned long bytecount = 0;
unsigned long waitcount = 0;
unsigned long longwaitcount = 0;
unsigned long keeptime = 0, timerd = 0, timer1 = 0, timer2 = 0, timer3 = 0, timeru = 0 , timerboot = 0, timerimpuls = 0, timerha = 0;
unsigned long timerprell = 0, timerhazeit = 0;
unsigned long timerschnecke = 0;
unsigned long timerpause = 0;
unsigned long timerHA = 0 ;
unsigned long kwhtimer = 0; // Zeit seit letzer KW Messung
int led=1; // Blaue Led Status

struct ef2
{
  double kwh = 0.1;
  double Rauchgastemperatur = 0.0;
  double Proztemperatur = 0.0;
  double Unterdruck = 0.0;
  double Brennerstunden = 0.0;
  double Kesseltemperatur = 0.0;
  double Geblaese = 0.1;  // damit initial Staus ausgegeben wird
  double Leistung = 0.0; 
  double Saugzug = 0.0;
  int  Reinigung = 0;
  int Zuendung = 0;
  int Drehrost = 0;
  int Schneckenlaufzeit = 0;
  int Schneckengesamtlaufzeit = 0;
  int KeineStoerung = 0;
  int Raumaustragung = 0;
  int Hauptantriebimpuls = 0; // Impulszähler
  int Hauptantrieb = 0 ;      // HAMotor Laufzeit in Millisekunden
  int HauptantriebUD = 0; // Umdrehungen Stoker
  unsigned long  Hauptantriebzeit = 1; // Gesamt HAzeit in millisekunden
  unsigned long  Hauptantriebtakt = 1; // Taktzeit in millisekunden
  int Pumpepuffer = 0;
  int RLAVentilauf = 0;
  int RLAVentilzu = 0;
  int ext = 1;
  double d[10];
  double photo = 0.0;
};

struct ef2 Kessel, oKessel; // akt. und "letzter" Kesselzustandd

WiFiClient espClient;
PubSubClient client(espClient);

#ifdef SWSERIAL
#include <SoftwareSerial.h>  // https://github.com/PaulStoffregen/SoftwareSerial
SoftwareSerial RS485Serial(RX, TX);
#endif

#include "espinclude.h"

//////////////////////////////////////////////////////////////////////////
//////////////////////////////////////////////////////////////////////////

// Wifi einschalten,, Verbinden und mqtt Connecten
// OTA einrichten

void wifi_on()
{


  WiFi.mode(WIFI_STA);
  WiFi.begin(ssid, password);
  while (WiFi.waitForConnectResult() != WL_CONNECTED) {
    // Serial.println("Connection Failed! Rebooting...");
    delay(5000);
    ESP.restart();
  }

  // Hostname defaults to esp8266-[ChipID]
  ArduinoOTA.setHostname(OTAHOST);

  ArduinoOTA.onStart([]() {
    String type;
    if (ArduinoOTA.getCommand() == U_FLASH) {
      type = "sketch";
    } else { // U_SPIFFS
      type = "filesystem";
    }
    // NOTE: if updating SPIFFS this would be the place to unmount SPIFFS using SPIFFS.end()
    //Serial.println("Start updating " + type);
  });
  ArduinoOTA.onEnd([]() {
    // Serial.println("\nEnd");
  });
  ArduinoOTA.onProgress([](unsigned int progress, unsigned int total) {
    //Serial.printf("Progress: %u%%\r", (progress / (total / 100)));
  });
  ArduinoOTA.onError([](ota_error_t error) {
    Serial.printf("Error[%u]: ", error);
    if (error == OTA_AUTH_ERROR) {
      // Serial.println("Auth Failed");
    } else if (error == OTA_BEGIN_ERROR) {
      // Serial.println("Begin Failed");
    } else if (error == OTA_CONNECT_ERROR) {
      // Serial.println("Connect Failed");
    } else if (error == OTA_RECEIVE_ERROR) {
      // Serial.println("Receive Failed");
    } else if (error == OTA_END_ERROR) {
      // Serial.println("End Failed");
    }
  });

  client.setServer(mqtt_server, 1883);
  //Serial.println("Ready");
  //Serial.print("IP address: ");
  //Serial.println(WiFi.localIP());
  wifistatus = 1;
}


// WIFi Abschalten
void wifi_off()
{

  mqttreconnect();
  client.publish("Info", "WIFI Off");
  delay(1999);
  WiFi.mode(WIFI_OFF);
  wifistatus = 0;
}

////////////////////// Setup //////////////////////////

void setup() {
  char msg[64];
  char rec[1000];

  // Serial.begin(19200);
  // Serial.println("Booting");

  wifi_on();


  ArduinoOTA.begin();
  mqttreconnect();
  client.setKeepAlive(5);
  ArduinoOTA.handle();

#ifdef SWSERIAL
  // RS485
  pinMode(RTS_pin, OUTPUT);
  // RS485
  pinMode(RX, INPUT);
  // Start the Modbus serial Port RS485
  RS485Serial.begin(19200);
  // RS485 Einlesen
  digitalWrite(RTS_pin, RS485Receive);      // Init Receive
  client.publish("info", "Booting (Software Serial)");
#else
  Serial.begin(19200);
  Serial.swap(); // RX auf Pin D7
  client.publish("info", "Booting (UART0 Serial)");
#endif

  sprintf(msg, "%d", updatemin );
  client.publish("updatemin", msg);

  sprintf(msg, "%f", NAfaktor );
  client.publish("NAfaktor", msg);

  sprintf(msg, "%f", HAfaktor );
  client.publish("HAfaktor", msg);

  sprintf(msg, "%.3f", 0);
  client.publish("kwh", msg);

  for (int r = 0; r < 10; r++)
  {
    Kessel.d[r] = 0.0;
  }

  // 10 Werte ausgeben um zu schauen ob die ser. tut und beim MQ alles ankommt...
  for (int r = 0; r < 10; r++)
  {
    rec[r] = readbyte();
  }


  // Setze CPU Speed auf 80mHz
  //REG_CLR_BIT(0x3ff00014, BIT(0));
  //os_update_cpu_frequency(80);

  // Setze CPU Speed auf 16mHz
  REG_SET_BIT(0x3ff00014, BIT(0));
  os_update_cpu_frequency(160);

  int r = 0;
  sprintf(msg, "bytes read RS485: %d %d %d %d %d %d %d %d %d %d", r, rec[r++], rec[r++], rec[r++], rec[r++], rec[r++], rec[r++], rec[r++], rec[r++], rec[r++], rec[r++] );
  client.publish("rec", msg);

  timerboot = millis();
  timer1 = millis();
  timeru = millis();
  keeptime = millis();
  timerd = millis();


  // Impulsstat
  timerpause = millis();
  id[0] = millis();
  ic++;


}



//////////////////////////////////////////////////////////////////////////
///////////////////// L O O P ////////////////////////////////////////////
//////////////////////////////////////////////////////////////////////////

void loop() {
  unsigned char anData[256];
  int nDataLen;
  char msg[500];
  int nID;;
 
  unsigned long  milli = 0;
  int frameid, error;

  // Setze CPU Speed auf 16mHz
  //REG_SET_BIT(0x3ff00014, BIT(0));
  //os_update_cpu_frequency(160);


  // Datenframe vom RS485 einlesen
  if (readframe(anData, nID, nDataLen, frameid, error))
  {
    milli = millis();

    // Led alternate bei Paketempfang

    pinMode(ledPin, OUTPUT);
    
    if(++led==2) {
      led=0;
      digitalWrite(ledPin, LOW);
      }
    else
      digitalWrite(ledPin, HIGH);
    
    ///////////////////////////////////
    // Control MSG  / Von Bediengerät an Kessel

    if (nID == 33)
    {
      // Kessel.Pumpepuffer = getbit(anData, 2, 7);
      Kessel.Pumpepuffer = getval2(anData, 8, 1, 100.0/255.0, 0);
      Kessel.Zuendung = getbit(anData, 16, 2);
      Kessel.KeineStoerung = getbit(anData, 3, 0);
      Kessel.Reinigung = getbit(anData, 3, 7);
      Kessel.Drehrost = getbit(anData, 3, 6);
      Kessel.Raumaustragung = getbit(anData, 9, 2);

      // Byte 2 Bit3 Motor läuft
      // Byte 2 Bit4 =1 auf =0 zu

      Kessel.RLAVentilzu = getbit(anData, 2, 3) & (getbit(anData, 2, 4) == 1);
      Kessel.RLAVentilauf  = getbit(anData, 2, 3) & (getbit(anData, 2, 4) == 0);

      Kessel.Hauptantrieb = getval2(anData, 12, 2, 10, 0);
      Kessel.Hauptantriebtakt = getval2(anData, 10, 2, 10, 0);



      //      if ( ddc < (DDC - 1)) ddc++;
      //      dd_t[ddc] = milli;
      //      dd_frameid[ddc] = frameid;
      //      dd_nID[ddc] = nID;

      // Frame speichern
      //      for (int i=DCCOFF;i<DCCOFF+DCCBYTES;i++)
      //      {
      //        dd_data[ddc][i-DCCOFF]=anData[i];
      //
      //      }
      // kwh summieren
      double deltat = (milli - kwhtimer) / (3600.0 * 1000.0); // in h

      // Hauptantrieb Range:  0 .. Kessel.Hauptantriebtakt

      if (oKessel.Hauptantriebtakt != 0 )
      {
        Kessel.Hauptantriebzeit += (oKessel.Hauptantrieb * (milli - timerHA)) / (oKessel.Hauptantriebtakt);
      }


      timerHA = milli;
      oKessel.Hauptantrieb = Kessel.Hauptantrieb;
      oKessel.Hauptantriebtakt = Kessel.Hauptantriebtakt;


      if (Kessel.Geblaese > 10) {
        Kessel.Brennerstunden += deltat; // Wenn der Kessel läuft
      }
      Kessel.kwh += Kessel.Leistung * deltat;
      kwhtimer = milli;
    }

    ///////////////////////////
    // Sense Paket empfangen
    if (nID == 32)
    {
      Kessel.photo =  getval2(anData, 32, 2, 0.1, 1);
      Kessel.Kesseltemperatur = getval2(anData, 12, 2, 0.1, 1);
      Kessel.Rauchgastemperatur = getval2(anData, 20, 2, 0.1, 1);
      Kessel.Proztemperatur = getval2(anData, 22, 2, 0.1, 1);
      Kessel.Unterdruck = getval2(anData, 34, 2, 0.1, 1);
      Kessel.Saugzug = getval2(anData, 69, 2, 0.6, 0);
      Kessel.Geblaese = getval2(anData, 71, 2, 0.6, 0);
      Kessel.ext = getbit(anData, 4, 7);
      Kessel.Hauptantriebimpuls = getbit(anData, 3, 7);


      // zwei gleiche impulse, die vom akt. unterschiedlich sind

      if ((Kessel.Hauptantriebimpuls == oKessel.Hauptantriebimpuls )
          && (Kessel.Hauptantriebimpuls != HAimp ))

      { // Hauptantrieb läuft und produziert Impulse

        HAimp = Kessel.Hauptantriebimpuls;
        Kessel.HauptantriebUD++; // vollst. Takte zählen



        last_errorcount = errorcounter;

        timerimpuls = milli;

        oKessel.Hauptantriebimpuls = Kessel.Hauptantriebimpuls;

      } // Impulsende

      oKessel.Hauptantriebimpuls = Kessel.Hauptantriebimpuls;

      // Wenn das Gebläse ausgeht ist auch Leistung auf 0 setzen, 
      // damit auch Brennerstunden korrekt berechnet werden 
        if ((Kessel.Geblaese == 0) && (oKessel.Geblaese > 10) )
          Kessel.Leistung=0;

          

    } // Ende Sense Paket auslesen

    // Raumaustragung = SchneckeBunker

    if ((Kessel.Raumaustragung == 0) && (oKessel.Raumaustragung == 1))
    {
      Kessel.Schneckenlaufzeit = (milli - timerschnecke) / 1000;
      if (Kessel.Schneckenlaufzeit > 800) Kessel.Schneckenlaufzeit = 0;

      Kessel.Schneckengesamtlaufzeit += Kessel.Schneckenlaufzeit;
    }
    if ((Kessel.Raumaustragung == 1) && (oKessel.Raumaustragung == 0))
    {
      timerschnecke = milli;
    }
    if ((Kessel.Raumaustragung == 0) && (oKessel.Raumaustragung == 0))
    {
      Kessel.Schneckenlaufzeit = 0;
    }
    //oKessel.Raumaustragung = Kessel.Raumaustragung;

  } // Ende Paket mit korr. Prüfsumme empfangen

  if (nID != 33 && nID != 32)
  {
    client.publish("error", "unknown Packet 32/33");
  }


  // Wichtig!!!
  // alle x Sekunden ## Update, damit OTA und Ping tun
  if (milli > (timeru + 5 * 1000))
  {

    if (nID == 33)
    {
     // mqttreconnect();
     //      sprintf(msg, "10:%5.0f HA12:%5.0f", getval2(anData, 10, 2, 10, 0), getval2(anData, 12, 2, 10, 0)    );
     // client.publish("controldata", msg);


      //      for (int j = 0; j <= 15; j = j + 5)
      //      { // String der inttibins sollte noch deleted werden
      //        sprintf(msg, "t:%4d id:%3d: %3d %s %s %s %s %s %2d", milli / 1000, frameid, j, inttobin(anData[j]), inttobin(anData[j + 1]), inttobin(anData[j + 2]), inttobin(anData[j + 3]), inttobin(anData[j + 4]), nDataLen);
      //        client.publish("sensedata", msg);
      //      }

      //       int j=4;
      //         // String der inttibins sollte noch deleted werden
      //       sprintf(msg, "t:%4d id:%3d: %3d %s %s %s %s %s %2d", milli / 1000, frameid, j, inttobin(anData[j]), inttobin(anData[j + 1]), inttobin(anData[j + 2]), inttobin(anData[j + 3]), inttobin(anData[j + 4]), nDataLen);
      //       client.publish("sensedata", msg);

    }


    timeru = milli;
    ArduinoOTA.handle(); // OTA nur wenn Kessel nicht brennt
    client.loop(); // Zeit für den Callback+MQTT Ping

  }


  // manche Werte direkt ausgeben,  wenn eine Änderung da ist
  // Wenn die Schnecke stehen geblieben ist und vorher lief Schneckenaufzeitausgeben
  if  (Kessel.Raumaustragung != oKessel.Raumaustragung)
  {
    if (Kessel.Raumaustragung == 0)
    {
      // live reporting Schneckenlaufzeitausgabe 
      mqttreconnect();
      sprintf(msg, "%d", Kessel.Schneckenlaufzeit);
      client.publish("Schneckenlaufzeit", msg);
      oKessel.Schneckenlaufzeit = Kessel.Schneckenlaufzeit;
    }
    oKessel.Raumaustragung = Kessel.Raumaustragung;

  }

//  if (Kessel.Pumpepuffer != oKessel.Pumpepuffer)
//      {
//        mqttreconnect();
//        sprintf(msg, "%d", Kessel.Pumpepuffer );
//        client.publish("Pumpepuffer", msg);
//        oKessel.Pumpepuffer = Kessel.Pumpepuffer;
//      }

//  if (Kessel.RLAVentilauf != oKessel.RLAVentilauf)
//      {
//        mqttreconnect();
//        sprintf(msg, "%d", Kessel.RLAVentilauf );
//        client.publish("RLAVentilauf", msg);
//        oKessel.RLAVentilauf=Kessel.RLAVentilauf;
//      }
  
//  if (Kessel.RLAVentilzu != oKessel.RLAVentilzu)
//      {
//        mqttreconnect();
//        sprintf(msg, "%d", Kessel.RLAVentilzu );
//        client.publish("RLAVentilzu", msg);
//        oKessel.RLAVentilzu=Kessel.RLAVentilzu;
//      }




  
  // braucht man nicht wirklich immer im Log
  //    if (Kessel.Drehrost != oKessel.Drehrost)
  //      {
  //        mqttreconnect();
  //        sprintf(msg, "%d", Kessel.Drehrost);
  //        client.publish("Drehrost", msg);
  //        oKessel.Drehrost=Kessel.Drehrost;
  //      }

  //  if (Kessel.ext != oKessel.ext)
  //  {
  //    if (Kessel.ext)
  //      // Wenn Anforderung da ist WIFI abschalten
  //      wifi_off();
  //    else
  //      wifi_on();
  //  }

  if (Kessel.Reinigung != oKessel.Reinigung)
  {

    mqttreconnect();
    sprintf(msg, "%d", Kessel.Reinigung);
    client.publish("Reinigung", msg);
    oKessel.Reinigung = Kessel.Reinigung;

  }

  if (Kessel.Zuendung != oKessel.Zuendung)
  {
    mqttreconnect();
    sprintf(msg, "%d", Kessel.Zuendung);
    client.publish("Zuendung", msg);
    oKessel.Zuendung = Kessel.Zuendung;
  }


  //////////////////// 5 min Block /////////////////////////////
  // Alle anderen Änderungen werden erst ausgegeben wenn
  // timer1 abgelaufen
  // wenn Änderung alle x*60 Sekunden Ausgabe an MQTT

  if (milli > (timer1 + updatemin * 60 * 1000))
  {

    // Wenn sich etwas an den Daten getan hat
    if (memcmp(&oKessel, &Kessel, sizeof(Kessel)))
    {
      mqttreconnect();


      // Aufzeichung ausgeben


      // int ed = ddc;

      //
      //     sprintf(msg,"%d",ed);
      //     client.publish("rec", msg);
      //
      //      for (int j = 1; j < ed; j++)
      //      {
      //        sprintf(msg, " j:%3d t:%7d %4d nid:%2d %d %d",j, dd_t[j],dd_frameid[j],dd_nID[j],dd_error[j],dd_d1[j]);
      //        client.publish("id", msg);
      //        ddc=0;
      //      }
      //
      //
      //

      // Auswertung Recording

      //      sprintf(msg, "Records %d",ed );
      //      client.publish("info", msg);
      //
      //      for(int b=0; b<DCCBYTES; b++)
      //       for(int bt=0; bt < 8 ; bt++)
      //         {
      //         int sum=0;
      //         for(int frm=1; frm<ed ; frm++)
      //           {
      //            if( (((dd_data[frm-1][b])>>bt)&1) !=    (((dd_data[frm][b])>>bt)&1)  ) sum++;
      //           }
      //           sprintf(msg, " b:%2d bit:%d sum:%d",b+DCCOFF,bt,sum );
      //           client.publish("id", msg);
      //         }

      //     ddc=0;

      //      int sumt=0;
      //      for (i = 1; i < ic; i++)
      //        {
      //        sprintf(msg, "i:%3d t:%d ha:%3d frame:%4d dt:%4d", i, id[i], idl[i], ifc[i], id[i] - id[i - 1]);
      //        sumt += (id[i] - id[i - 1]);
      //        client.publish("id", msg);
      //        }
      //
      //      ic = 1; id[0] = millis();
      //
      //      sprintf(msg, "sumt: %d", sumt);
      //      client.publish("info", msg);

      //sprintf(msg, "%d", (bytecounter * 1000) / (milli - timer1));
      //client.publish("bytecounter", msg);
      bytecounter = 0;

      sprintf(msg, "%d / %d", framecounter, errorcounter);
      client.publish("frames/errors", msg);
      framecounter = 0;
      errorcounter = 0;


      //sprintf(msg, "%d", Kessel.HauptantriebUD);
      //client.publish("HauptantriebUD", msg);

      //sprintf(msg, "%d", Kessel.Hauptantriebzeit / 1000);
      //client.publish("Hauptantriebzeit", msg);

      //sprintf(msg, "%2.1f", (double) Kessel.Hauptantriebtakt / 1000.0);
      //client.publish("Hauptantriebtakt", msg);

      sprintf(msg, "%d", (int)( (((double)Kessel.Hauptantriebzeit)*HAfaktor) / 1000));
      client.publish("Pellets", msg);

      // Messung Über Schneckenantrieb
      sprintf(msg, "%d", (int)(((float)Kessel.Schneckengesamtlaufzeit * NAfaktor)  ));

      client.publish("PelletsNA", msg);

      // akt Verbrauch berechnen
      if (Kessel.HauptantriebUD - UD)
      {
        int d, p;
        d = (Kessel.HauptantriebUD - UD) * 3600 * 1000 / (milli - timerd);

        // Besp   3.58 * 60 * 60    1000ms / 5000ms
        p = (int) (HAfaktor * 60 * 60 * ( Kessel.Hauptantriebzeit - ZD) ) / (milli - timerd) ;
        sprintf(msg, "%d", p);
        client.publish("deltaPelletsh", msg);

        Kessel.Leistung = LEISTUNGKESSEL * TAKT100 * ((double) ( Kessel.Hauptantriebzeit - ZD)) / ((double) (milli - timerd)) ;
        sprintf(msg, "%2.1f", Kessel.Leistung);
        client.publish("Leistung", msg);
        
        if (Kessel.Leistung < 1.0 )
        {
          client.publish("deltaPelletsh", "0");
        }
        


        // Verbrauch pro Stunde gemessen über NA
        sprintf(msg, "%d", (int) ((float)(Kessel.Schneckengesamtlaufzeit - SL) * NAfaktor * 1000.0 * 3600.0 / ( milli - timerd)));
        client.publish("deltaPelletsNAh", msg);


        SL = Kessel.Schneckengesamtlaufzeit;

        UD = Kessel.HauptantriebUD;
        //sprintf(msg, "%d", (millis() - timerd) / 1000);
        //client.publish("deltat", msg);
        ZD = Kessel.Hauptantriebzeit;
        timerd = milli;
      }

      //////////////////////////////////////////////
      // Berechnung HA/NA Verhältnis
      // Alle xx Min  berechnen (-> ca. 1.9 wenn der sinkt gibt es Förderprobleme)

      if (milli > ( HANAtimer + 30 * 60  * 1000))
      {
        HANAtimer = milli;
        double v;

        if ((Kessel.Hauptantriebzeit - HAz) && (Kessel.Schneckengesamtlaufzeit - NAz)) // Wenn der HA lief
        {
          v = (float) (Kessel.Hauptantriebzeit - HAz) / ((float)(Kessel.Schneckengesamtlaufzeit - NAz) * 1000.0  ) ;
          sprintf(msg, "%f", v);
          client.publish("HANA", msg);
          NAz = Kessel.Schneckengesamtlaufzeit;
          HAz = Kessel.Hauptantriebzeit;
        }
      }

      if (Kessel.Schneckengesamtlaufzeit != oKessel.Schneckengesamtlaufzeit)
      {
        oKessel.Schneckengesamtlaufzeit = Kessel.Schneckengesamtlaufzeit;
      }

      if (Kessel.KeineStoerung != oKessel.KeineStoerung)
      {
        sprintf(msg, "%d", 1 - Kessel.KeineStoerung);
        client.publish("Stoerung", msg);
      }


      oKessel.Leistung = Kessel.Leistung;


      if (Kessel.kwh != oKessel.kwh)
      {
        sprintf(msg, "%.3f", Kessel.kwh);
        client.publish("kwh", msg);
      }

      if (Kessel.Brennerstunden != oKessel.Brennerstunden)
      {
        sprintf(msg, "%.3f", Kessel.Brennerstunden);
        client.publish("Brennerstunden", msg);
      }



      if (Kessel.Raumaustragung != oKessel.Raumaustragung)
      {
        sprintf(msg, "%d", Kessel.Raumaustragung);
        client.publish("Raumaustragung", msg);
      }

      if (Kessel.Kesseltemperatur != oKessel.Kesseltemperatur)
      {
        sprintf(msg, "%.1f", Kessel.Kesseltemperatur);
        client.publish("Kesseltemperatur", msg);
      }
      if (Kessel.Rauchgastemperatur != oKessel.Rauchgastemperatur)
      {
        sprintf(msg, "%.1f", Kessel.Rauchgastemperatur);
        client.publish("Rauchgastemperatur", msg);
      }

      if ((Kessel.Saugzug != oKessel.Saugzug ) || (Kessel.Geblaese != oKessel.Geblaese))
      {
        sprintf(msg, "%.0f / %.0f", Kessel.Saugzug,Kessel.Geblaese);
        client.publish("Saugzug", msg);
        sprintf(msg, "%.1f", Kessel.Unterdruck );
        client.publish("Unterdruck", msg);
        
        if (Kessel.Geblaese > 10.0)
          client.publish("Kessel", "brennt");
        else
          {
          client.publish("Kessel", "aus");
          client.publish("Leistung", "0");
          }


      }
     

      sprintf(msg, "%d", Kessel.ext);
      client.publish("Anforderung", msg);

      if (Kessel.photo != oKessel.photo)
      {
        sprintf(msg, "%d", ((int) (Kessel.photo + 255.0) * 100) >> 9);
        client.publish("photodiode", msg);
        //sprintf(msg, "%d", ((int) (Kessel.photo )));
        //client.publish("photoraw", msg);
        //sprintf(msg, "%s %s %d %d", inttobin(p1),inttobin(p2),(int) p1, (int) p2 );
        //client.publish("photobin",msg );
        
      }

      memcpy(&oKessel, &Kessel, sizeof Kessel);

    }

    timer1 = milli;

  } // timer1 Ausgabe alle 5min

  // Delay am Loopende damit SW Watchdog nicht auslöst
  delay(5);
}
