windundsterne/esp-kwb-mqttlogger/(commit log)

2022-01-17 Messung optimiert
    160Mhz
    weniger Updates, millis Calls reduziert
2022-01-18 Stats bytes/frames/errors + Codeoptimierungeb
    [esp-kwb-mqttlogger.ino, espinclude.h]
2022-01-22 Div. Opt. zur Reduzierung der CRC Fehler (lft.)
2022-01-23 Serial Nutzung beseitigt damit UART0 frei ist
2022-01-30 Auswertung bits aus Frame33
2022-02-08 Publish Schneckenlaufzeit
    Antriebszeiten der Schnecke direkt ausgeben
2022-02-08 Schlatplan für Serial RX
    zur Verwendung des UART0 statt des Softwareserial
2022-03-04 Update esp-kwb-mqttlogger.ino
    pot. Div/zero besitigt und Hinweis zur Speicherfreigabe bei inttobins
2022-03-15 Update README.md
    UART und SWSerial Hinweis
2023-02-01 Leistung Verbrauch korrigiert
    NA-Messung an HA angepasst.
    Leistung geht nun auf 0 wenn der Kessel aus ist
    Brennerstunden korrigiert
    temp. Ausgabe photo raw
    [esp-kwb-mqttlogger.ino]
2023-02-01 Pufferpumpe und RLA Ventil
2023-02-01 git filter-branch --prune-empty --index-filter 'git rm --cached --ignore-unmatch <file>' --tag-name-filter cat -- --all
